Neobotics-Foundation-Inc/neoracer-pcb-firmware/(list of files, cad)

Other CAD files:
hardware/NEORACER_V1_OSCORE_NEO_Board_3D_Model_STEP_RevA_20260624.step
