Neobotics-Foundation-Inc/neoracer-pcb-firmware/hardware/NEORACER_V1_OSCORE_NEO_PCB_Reference_Designator_Map_RevA_20260624.pdf

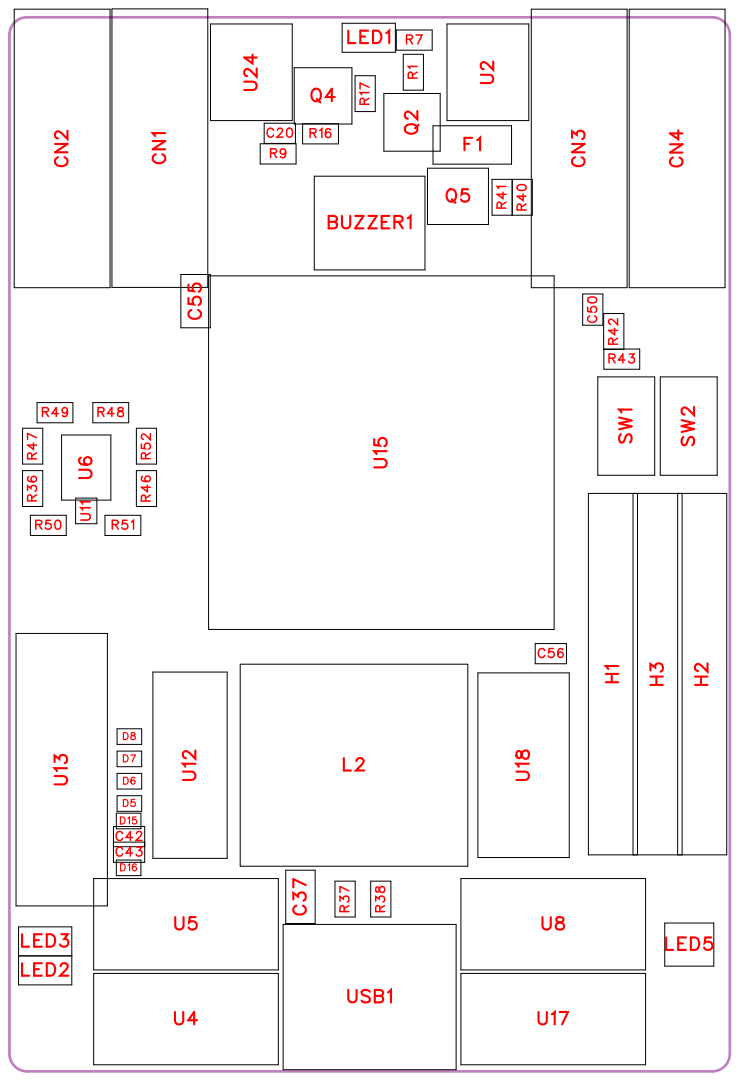
[picture p1: page 1]

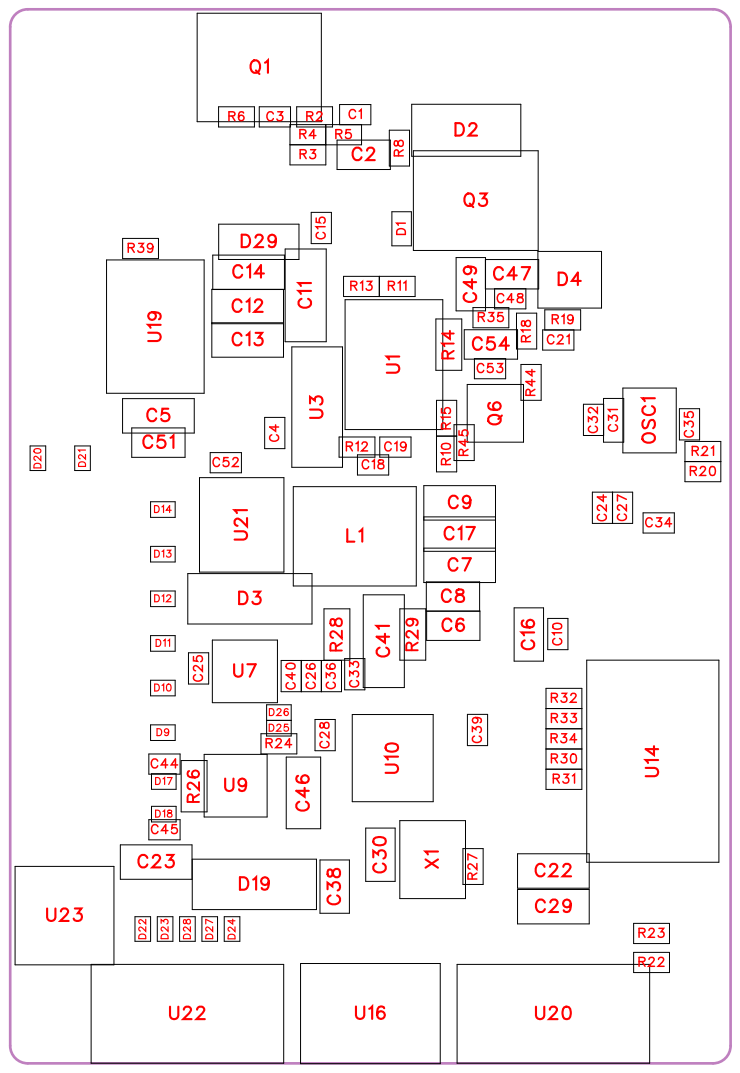
[picture p2: page 2]

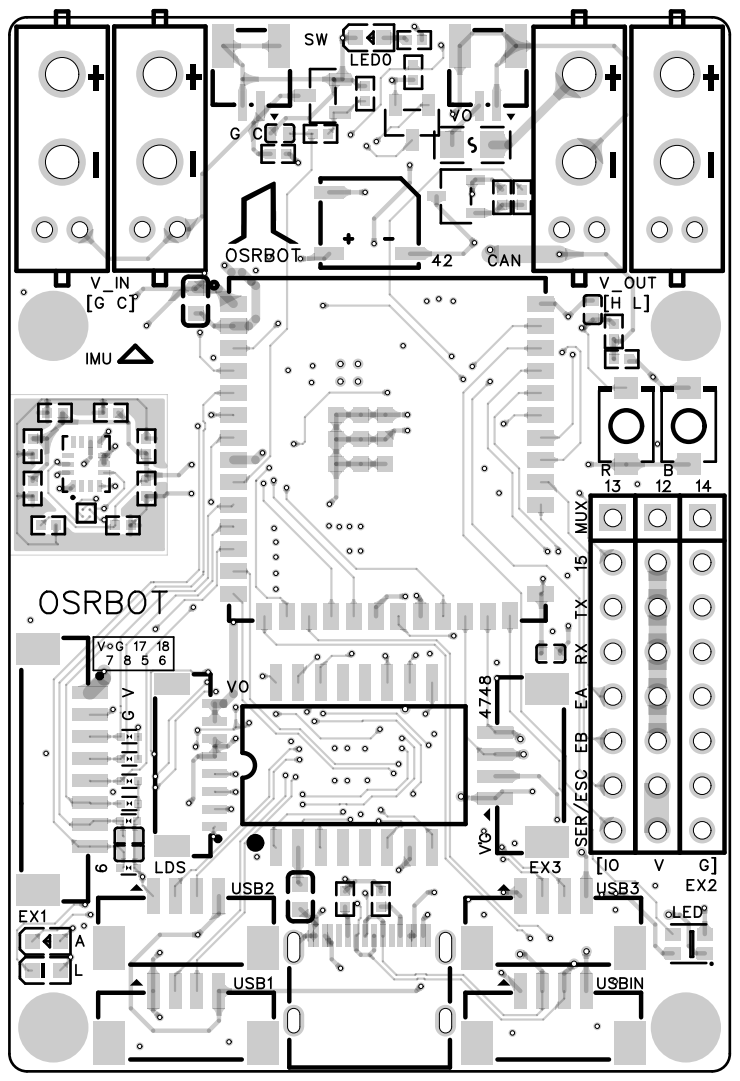
[picture p3: page 3]

SER/ESC EB EA RX TX

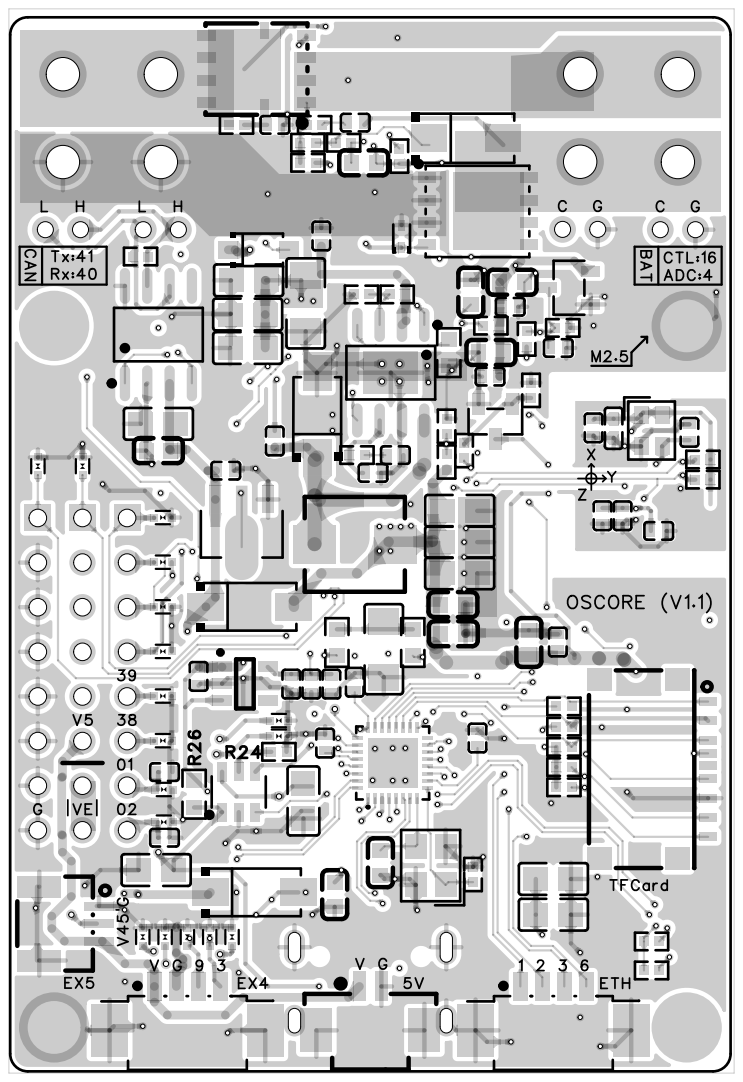
[picture p4: page 4]

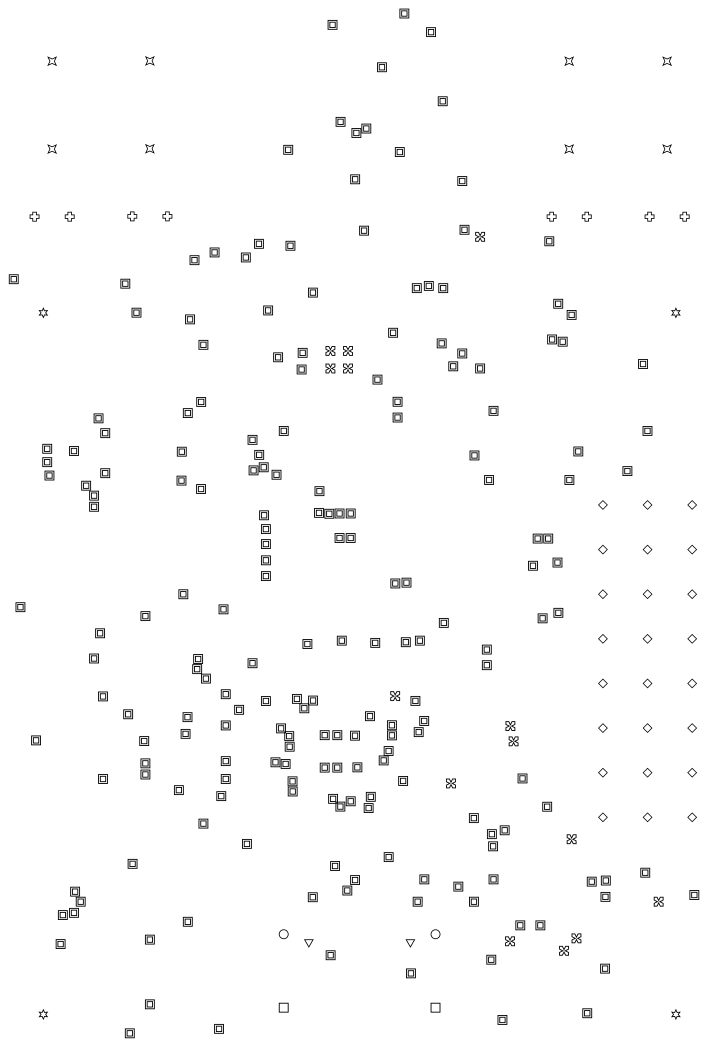
[picture p5: page 5]
