Neobotics-Foundation-Inc/neoracer-pcb-firmware/hardware/NEORACER_V1_OSCORE_NEO_Schematic_RevA_20260624.pdf

# Power Input

# Battery Input 9 26V

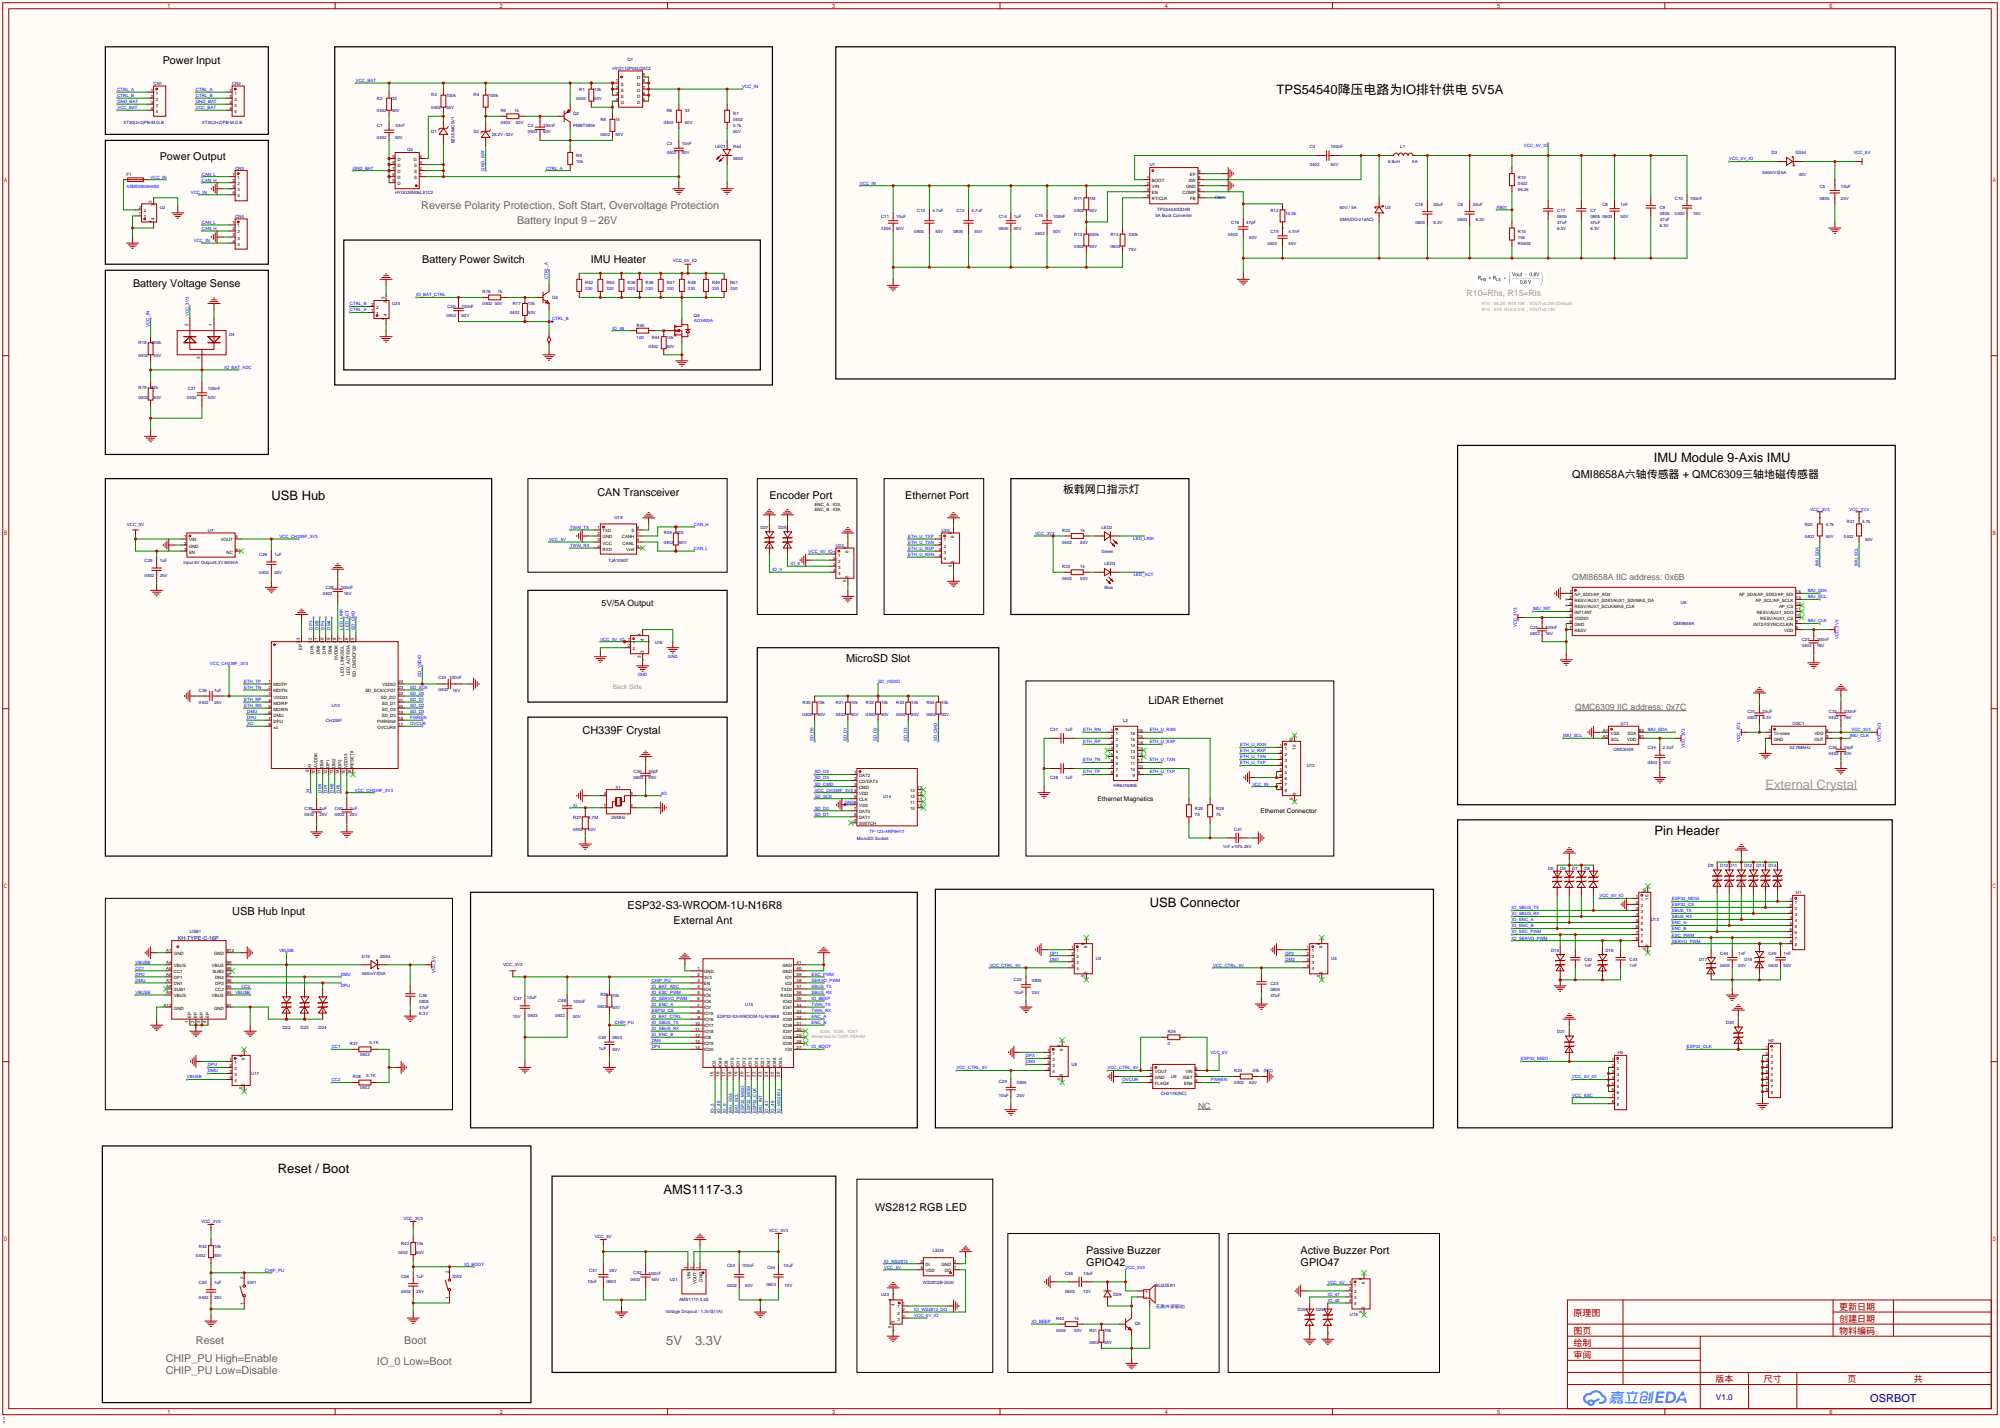
[picture p6: page 1]

IMU Module 9-Axis IMU

Reserved for OSPI PSRAM

# 电源输入端

# 防反接，上电缓启动，过压保护

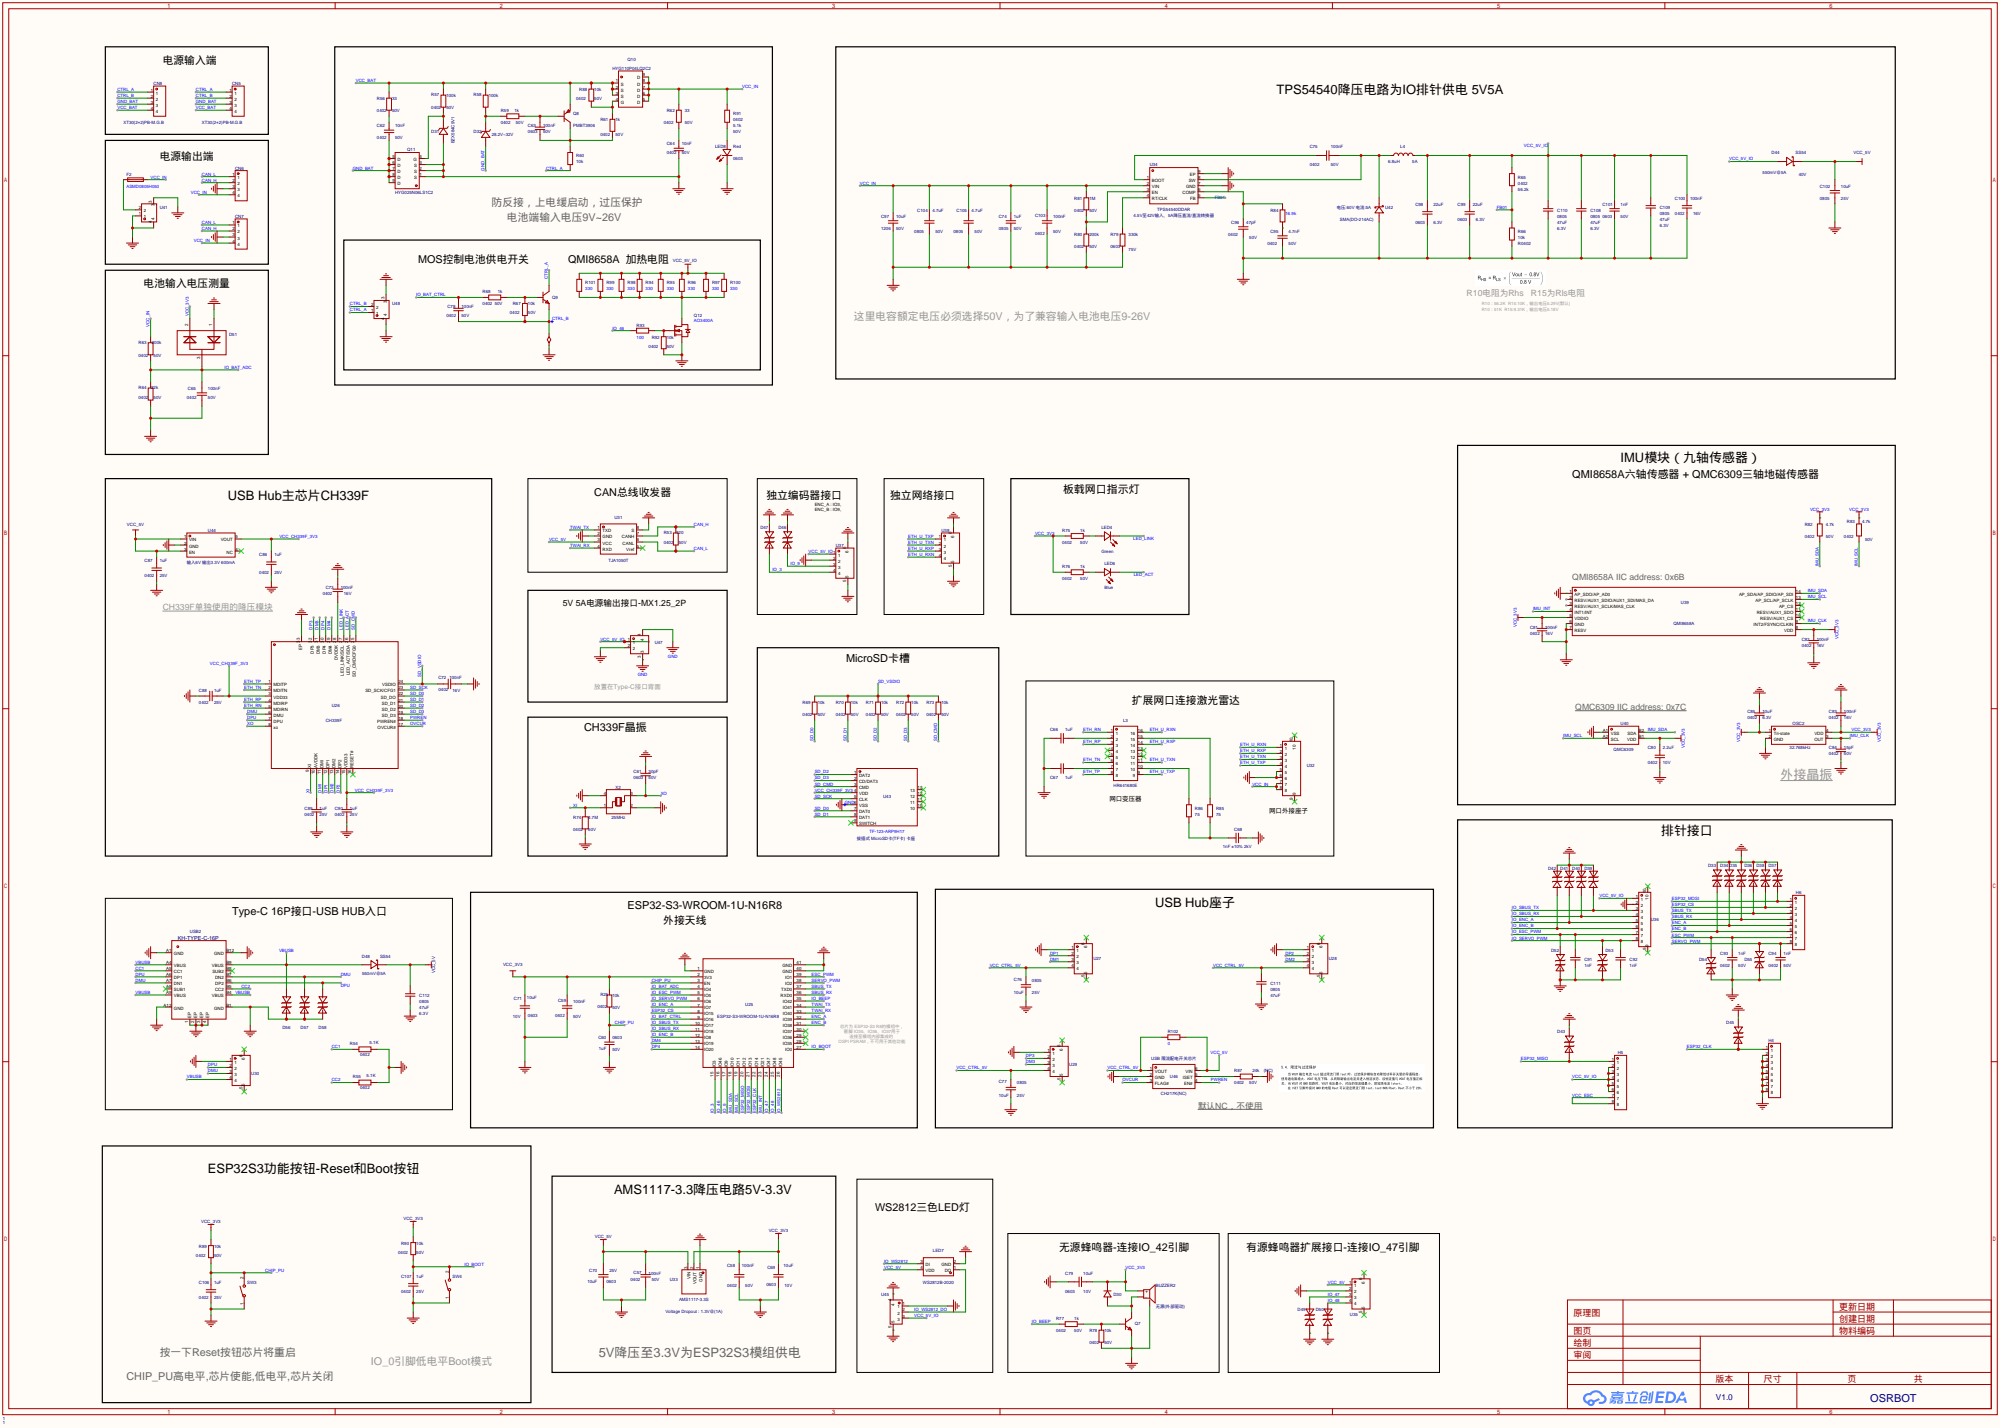
[picture p7: page 2]

TF-123-ARP9H17
拔插式 MicroSD卡(TF卡) 卡座
